RoboticsBrno/Saturn/saturn.kicad_pcb

## KiCad design saturn.kicad_pcb (2026-05-17)

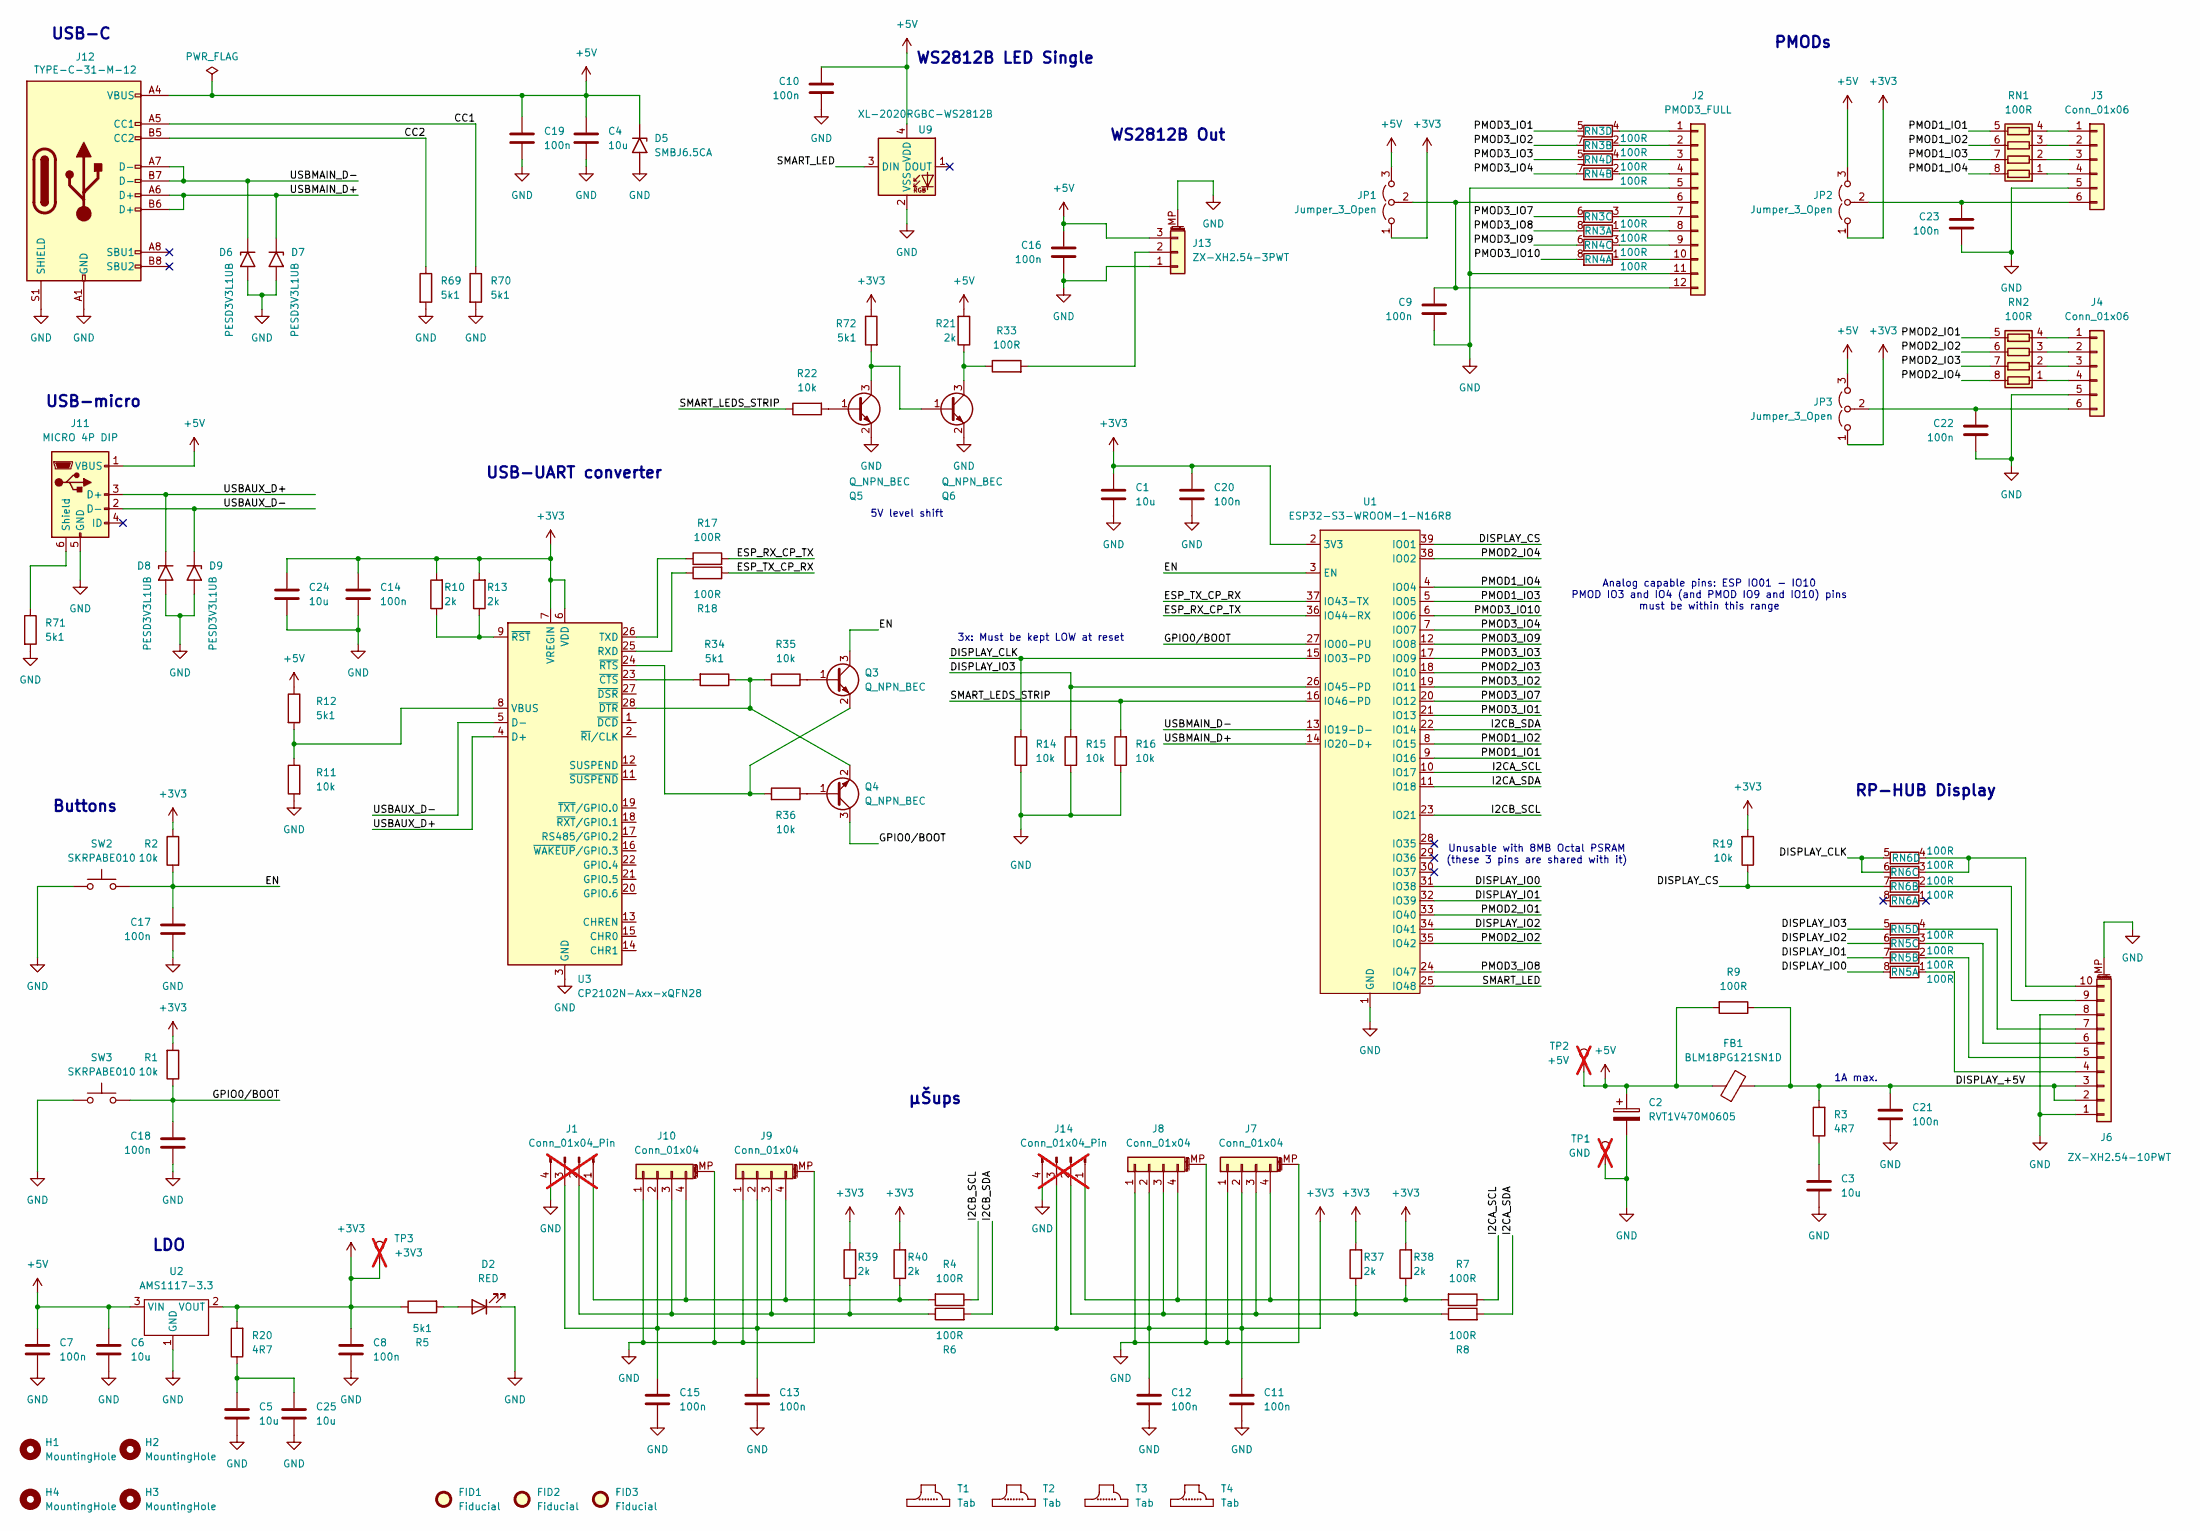
[picture p1: schematic saturn.kicad_sch]

Parts:
C1, C3, C4, C5, C6, C24, C25: 10u; C_0805_2012Metric; LCSC C15850
C2: RVT1V470M0605; CP_Elec_6.3x5.4; LCSC C72522
C7, C8, C9, C10, C11, C12, C13, C14, C15, C16, C17, C18, C19, C20, C21, C22, C23: 100n; C_0402_1005Metric; LCSC C307331
D2: RED; LED_0603_1608Metric; LCSC C965799
D5: SMBJ6.5CA; D_SMB; LCSC C7420377
D6, D7, D8, D9: PESD3V3L1UB; D_SOD-523; LCSC C3001945
FB1: BLM18PG121SN1D; L_0603_1608Metric; LCSC C14709
FID1, FID2, FID3: Fiducial; Fiducial_1mm_Mask2mm
H1, H2, H3, H4: MountingHole; MountingHole_3.2mm_M3_DIN965
J1, J14: Conn_01x04_Pin; PinSocket_1x04_P2.54mm_Vertical; not fitted
J2: PMOD3_FULL; PinSocket_PMOD_full; LCSC C2897426
J3, J4: Conn_01x06; PinSocket_PMOD_Half; LCSC C2897388
J6: ZX-XH2.54-10PWT; JST-XH-SMD-10Pin; LCSC C7429679
J7, J8, J9, J10: Conn_01x04; JST_SH_SM04B-SRSS-TB_1x04-1MP_P1.00mm_Horizontal; LCSC C7430446
J11: MICRO 4P DIP; USB_MICRO 4P DIP; LCSC C456008
J12: TYPE-C-31-M-12; USB_C_Receptacle_HRO_TYPE-C-31-M-12_With_THR_Paste; LCSC C165948
J13: ZX-XH2.54-3PWT; JST-XH-SMD-3Pin; LCSC C7429672
JP1, JP2, JP3: Jumper_3_Open; PinHeader_1x03_P2.54mm_Vertical_SMD_Pin1Left_LargePads; LCSC C41417360
Q3, Q4, Q5, Q6: Q_NPN_BEC; SOT-23; LCSC C20526
R1, R2, R11, R14, R15, R16, R19, R22, R35, R36: 10k; R_0402_1005Metric; LCSC C25744
R3, R20: 4R7; R_0805_2012Metric; LCSC C17675
R4, R6, R7, R8, R9, R17, R18, R33: 100R; R_0402_1005Metric; LCSC C25076
R5, R12, R34, R69, R70, R71, R72: 5k1; R_0402_1005Metric; LCSC C25905
R10, R13, R21, R37, R38, R39, R40: 2k; R_0402_1005Metric; LCSC C4109
RN1, RN2, RN3, RN4, RN5, RN6: 100R; R_Array_Convex_4x0603; LCSC C25506
SW2, SW3: SKRPABE010; SW_SMD_LargePads; LCSC C115360
T1, T2, T3, T4: Tab
TP1: GND; PinHeader_1x01_P2.54mm_Vertical; not fitted
TP2: +5V; PinHeader_1x01_P2.54mm_Vertical; not fitted
TP3: +3V3; PinHeader_1x01_P2.54mm_Vertical; not fitted
U1: ESP32-S3-WROOM-1-N16R8; ESP32-S3-WROOM; LCSC C2913202
U2: AMS1117-3.3; SOT-223-3_TabPin2; LCSC C6186
U3: CP2102N-Axx-xQFN28; QFN-28-1EP_5x5mm_P0.5mm_EP3.35x3.35mm; LCSC C964632
U9: XL-2020RGBC-WS2812B; LED_WS2812B-2020_PLCC4_2.0x2.0mm; LCSC C5349955

Connections:
+3V3: C1.1, C8.1, C11.1, C12.1, C13.1, C14.1, C15.1, C20.1, C24.1, J1.3, J7.2, J8.2, J9.2, J10.2, J14.3, JP1.1 (A), JP2.1 (A), JP3.1 (A), R1.2, R2.1, R5.1, R10.2, R13.2, R19.2, R20.2, R37.2, R38.2, R39.2, R40.2, R72.1, TP3.1 (1_1), U1.2 (3V3), U2.2 (VOUT), U3.6 (VDD), U3.7 (VREGIN)
+5V: C2.1, C4.1, C6.1, C7.1, C10.1, C16.1, C19.1, D5.1 (A1), FB1.1, J11.1 (VBUS), J12.A4 (VBUS), J12.A9 (VBUS), J12.B4 (VBUS), J12.B9 (VBUS), J13.3, JP1.3 (B), JP2.3 (B), JP3.3 (B), R9.2, R12.1, R21.2, TP2.1 (1_1), U2.3 (VIN), U9.4 (VDD)
/CC1: J12.A5 (CC1), R70.1
/CC2: J12.B5 (CC2), R69.1
/DISPLAY_+5V: C21.1, FB1.2, J6.2, J6.3, R3.2, R9.1
/DISPLAY_CLK: R14.2, RN6.5 (R4.2), RN6.6 (R3.2), U1.15 (IO03-PD)
/DISPLAY_CS: R19.1, RN6.7 (R2.2), U1.39 (IO01)
/DISPLAY_IO0: RN5.8 (R1.2), U1.31 (IO38)
/DISPLAY_IO1: RN5.7 (R2.2), U1.32 (IO39)
/DISPLAY_IO2: RN5.6 (R3.2), U1.34 (IO41)
/DISPLAY_IO3: R15.2, RN5.5 (R4.2), U1.26 (IO45-PD)
/EN: C17.1, Q3.3 (C), R2.2, SW2.1, U1.3 (EN)
/ESP_RX_CP_TX: R17.2, U1.36 (IO44-RX)
/ESP_TX_CP_RX: R18.2, U1.37 (IO43-TX)
/GPIO0/BOOT: C18.1, Q4.3 (C), R1.1, SW3.1, U1.27 (IO00-PU)
/I2CA_SCL: R7.1, U1.10 (IO17)
/I2CA_SDA: R8.2, U1.11 (IO18)
/I2CB_SCL: R4.1, U1.23 (IO21)
/I2CB_SDA: R6.2, U1.22 (IO14)
/PMOD1_IO1: RN1.5 (R4.2), U1.9 (IO16)
/PMOD1_IO2: RN1.6 (R3.2), U1.8 (IO15)
/PMOD1_IO3: RN1.7 (R2.2), U1.5 (IO05)
/PMOD1_IO4: RN1.8 (R1.2), U1.4 (IO04)
/PMOD2_IO1: RN2.5 (R4.2), U1.33 (IO40)
/PMOD2_IO2: RN2.6 (R3.2), U1.35 (IO42)
/PMOD2_IO3: RN2.7 (R2.2), U1.18 (IO10)
/PMOD2_IO4: RN2.8 (R1.2), U1.38 (IO02)
/PMOD3_IO1: RN3.5 (R4.2), U1.21 (IO13)
/PMOD3_IO2: RN3.7 (R2.2), U1.19 (IO11)
/PMOD3_IO3: RN4.5 (R4.2), U1.17 (IO09)
/PMOD3_IO4: RN4.7 (R2.2), U1.7 (IO07)
/PMOD3_IO7: RN3.6 (R3.2), U1.20 (IO12)
/PMOD3_IO8: RN3.8 (R1.2), U1.24 (IO47)
/PMOD3_IO9: RN4.6 (R3.2), U1.12 (IO08)
/PMOD3_IO10: RN4.8 (R1.2), U1.6 (IO06)
/SMART_LED: U1.25 (IO48), U9.3 (DIN)
/SMART_LEDS_STRIP: R16.2, R22.1, U1.16 (IO46-PD)
/USBAUX_D+: D8.1 (A1), J11.3 (D+), U3.4 (D+)
/USBAUX_D-: D9.1 (A1), J11.2 (D-), U3.5 (D-)
/USBMAIN_D+: D7.1 (A1), J12.A6 (D+), J12.B6 (D+), U1.14 (IO20-D+)
/USBMAIN_D-: D6.1 (A1), J12.A7 (D-), J12.B7 (D-), U1.13 (IO19-D-)
GND: C1.2, C2.2, C3.2, C4.2, C5.2, C6.2, C7.2, C8.2, C9.2, C10.2, C11.2, C12.2, C13.2, C14.2, C15.2, C16.2, C17.2, C18.2, C19.2, C20.2, C21.2, C22.2, C23.2, C24.2, C25.2, D2.1 (K), D5.2 (A2), D6.2 (A2), D7.2 (A2), D8.2 (A2), D9.2 (A2), J1.4, J2.5, J2.11, J3.5, J4.5, J6.1, J6.8, J6.MP (MountPin), J7.1, J7.MP (MountPin), J8.1, J8.MP (MountPin), J9.1, J9.MP (MountPin), J10.1, J10.MP (MountPin), J11.5 (GND), J12.A1 (GND), J12.A12 (GND), J12.B1 (GND), J12.B12 (GND), J12.S1 (SHIELD), J13.1, J13.MP (MountPin), J14.4, Q5.2 (E), Q6.2 (E), R11.2, R14.1, R15.1, R16.1, R69.2, R70.2, R71.2, SW2.2, SW3.2, TP1.1 (1_1), U1.1 (GND), U1.40 (GND), U1.41 (GND), U2.1 (GND), U3.3 (GND), U3.29 (GND), U9.2 (VSS)
unnamed: C3.1, R3.1
unnamed: C5.1, C25.1, R20.1
unnamed: D2.2 (A), R5.2
unnamed: J1.1, J9.4, J10.4, R4.2, R40.1
unnamed: J1.2, J9.3, J10.3, R6.1, R39.1
unnamed: J2.1, RN3.4 (R4.1)
unnamed: J2.2, RN3.2 (R2.1)
unnamed: J2.3, RN4.4 (R4.1)
unnamed: J2.4, RN4.2 (R2.1)
unnamed: J2.7, RN3.3 (R3.1)
unnamed: J2.8, RN3.1 (R1.1)
unnamed: J2.9, RN4.3 (R3.1)
unnamed: J2.10, RN4.1 (R1.1)
unnamed: C9.1, J2.6, J2.12, JP1.2 (C)
unnamed: J3.1, RN1.4 (R4.1)
unnamed: J3.2, RN1.3 (R3.1)
unnamed: J3.3, RN1.2 (R2.1)
unnamed: J3.4, RN1.1 (R1.1)
unnamed: C23.1, J3.6, JP2.2 (C)
unnamed: J4.1, RN2.4 (R4.1)
unnamed: J4.2, RN2.3 (R3.1)
unnamed: J4.3, RN2.2 (R2.1)
unnamed: J4.4, RN2.1 (R1.1)
unnamed: C22.1, J4.6, JP3.2 (C)
unnamed: J6.4, RN5.1 (R1.1)
unnamed: J6.5, RN5.2 (R2.1)
unnamed: J6.6, RN5.3 (R3.1)
unnamed: J6.7, RN5.4 (R4.1)
unnamed: J6.9, RN6.2 (R2.1)
unnamed: J6.10, RN6.3 (R3.1), RN6.4 (R4.1)
unnamed: J11.6 (Shield), R71.1
unnamed: J13.2, R33.2
unnamed: J7.4, J8.4, J14.1, R7.2, R38.1
unnamed: J7.3, J8.3, J14.2, R8.1, R37.1
unnamed: Q3.1 (B), R35.1
unnamed: Q3.2 (E), R36.2, U3.24 (~RTS)
unnamed: Q4.1 (B), R36.1
unnamed: Q4.2 (E), R34.1, R35.2, U3.28 (~DTR)
unnamed: Q5.1 (B), R22.2
unnamed: Q5.3 (C), Q6.1 (B), R72.2
unnamed: Q6.3 (C), R21.1, R33.1
unnamed: R18.1, U3.25 (RXD)
unnamed: R17.1, U3.26 (TXD)
unnamed: R11.1, R12.2, U3.8 (VBUS)
unnamed: R34.2, U3.23 (~CTS)
unnamed: R10.1, R13.1, U3.9 (~RST)

Notes on the sheet:
USB-UART converter
Unusable with 8MB Octal PSRAM (these 3 pins are shared with it)
WS2812B LED Single
3x: Must be kept LOW at reset
1A max.
RP-HUB Display
µŠups
PMODs
USB-micro
WS2812B Out
USB-C
LDO
5V level shift
Buttons
Analog capable pins: ESP IO01 - IO10 PMOD IO3 and IO4 (and PMOD IO9 and IO10) pins must be within this range

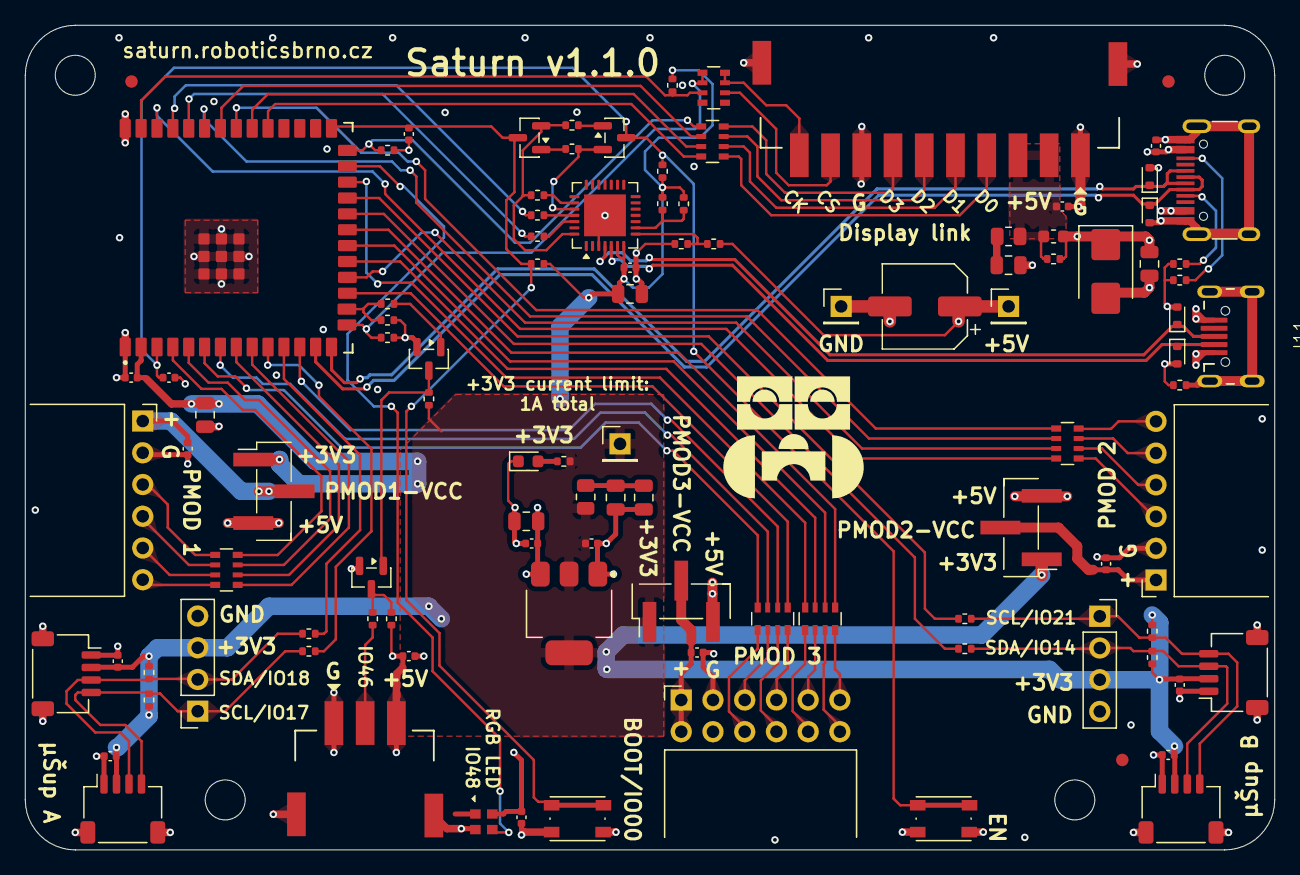
[picture p2: board saturn.kicad_pcb from above]

Board: 4 copper layers, 100.0 x 66.0 mm, 112 parts (0 on the bottom side), 88 nets.
