RoboticsBrno/Saturn/(commit log)

2026-02-27 Add hw review 2nd version
    [saturn.kicad_pcb, saturn.kicad_sch]
2026-03-03 Release v1.0.0
    [bom.csv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]
2026-04-11 Switch to Kicad 10
    [saturn.kicad_sch]
2026-04-23 Fix PMOD ADC pin assignment, tune silkscreen
    [saturn.kicad_pcb, saturn.kicad_sch]
2026-04-25 Add PMOD polarity mark on Top
    [saturn.kicad_pcb]
2026-04-25 Fix 5V unroute
    [saturn.kicad_pcb]
2026-04-25 Use unipolar TVS diodes, tune switch values
    [saturn.kicad_pcb, saturn.kicad_sch]
2026-04-25 Use SMT PMOD jumper header
    [saturn.kicad_pcb, saturn.kicad_sch]
2026-04-25 Use SMT JST-XH connectors
    [saturn.kicad_pcb, saturn.kicad_sch]
2026-04-25 Tune silkscreen
    [saturn.kicad_pcb]
2026-05-10 Tune silkscreen, enlarge SMT switch pads
    [saturn.kicad_pcb, saturn.kicad_sch]
2026-05-10 Add project-specific ESP32, USB, WS2812B footprints
2026-05-10 Add enlarge-pad switch footprint
2026-05-10 Add fubar Button 3D model
2026-05-13 Use 0805 10u capacitors (cheaper)
    [saturn.kicad_pcb, saturn.kicad_sch]
2026-05-13 Use AMS1117-3.3 LDO (cheaper)
    [saturn.kicad_pcb, saturn.kicad_sch]
2026-05-13 Add LDO output cap series resistance
    [saturn.kicad_pcb, saturn.kicad_sch]
2026-05-16 Separate LED Strip to IO46 with level shift, tune layout
    [saturn.kicad_pcb, saturn.kicad_sch]
2026-05-17 Tune layout, POS corrections, kik.json
    [saturn.kicad_pcb, saturn.kicad_sch]
2026-05-17 Ignore -bridged-wtf-DRC-thing-, tune Makefile
    [saturn.kicad_pcb]
2026-05-17 Replace Micro-USB connector
    [saturn.kicad_pcb, saturn.kicad_sch]
2026-05-17 Release v1.1.0
    [bom.csv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]
